brandonpollack23/super_game_bro/SW/images/lcd-image-converter/readme.txt

LCD Image Converter
Tool to create bitmaps and fonts for embedded applications, v.2
This program allows you to create bitmaps and fonts, and transform them to "C"
source format for embedded applications.

Home page: http://code.google.com/p/lcd-image-converter/
Mailto:    riuson@gmail.com

================================================================================
This program is free software: you can redistribute it and/or modify
it under the terms of the GNU General Public License as published by
the Free Software Foundation, either version 3 of the License, or
(at your option) any later version.

This program is distributed in the hope that it will be useful,
but WITHOUT ANY WARRANTY; without even the implied warranty of
MERCHANTABILITY or FITNESS FOR A PARTICULAR PURPOSE.  See the
GNU General Public License for more details.

You should have received a copy of the GNU General Public License
along with this program.  If not, see <http://www.gnu.org/licenses/

================================================================================
