brandonpollack23/super_game_bro/doc/CARTRIDGES/IDFReport_SD_MMC Breakout-v20.html

Altium customize

# IDF File Translation Report

Date | : | 2/13/15
Time | : | 3:56:46 PM
Elapsed Time | : | 00:00:00
PCB Filename | : | \\psf\Dropbox\school\SENIORDESIGN\Altium\SuperGameBro_RevA0\SuperGameBro_RevA0.PcbDoc
IDF Board Filename | : | \\psf\Dropbox\school\SENIORDESIGN\doc\cartridges\SD_MMC Breakout-v20.brd
IDF Library Filename | : | \\psf\Dropbox\school\SENIORDESIGN\doc\cartridges\SD_MMC Breakout-v20.pro

Load Errors

File : \\psf\Dropbox\school\SENIORDESIGN\doc\cartridges\SD_MMC Breakout-v20.brd Line : 3 Char : 2 Unknown IDF file section name <!DOCTYPE.

Back to top

Import Errors

Back to top

Load Warnings

Back to top

Import Warnings

Back to top

Errors

Back to top

Warnings

Back to top
