brandonpollack23/super_game_bro/doc/Butttons/Untitled.rtf

http://www.digikey.com/product-detail/en/15551/679-1964-ND/2034520 L+R button
http://www.digikey.com/product-detail/en/1630006/679-1971-ND/2034527 cap
