brandonpollack23/super_game_bro/Reports/Preliminary Design/Ganttchart.xls

Sheet: Gantt1
Task Name |  | Riley | Brandon | Team
Introduction (team) | 0 | 0 | 0 | 1 | 1
Research/project proposal (team) | 0 | 0 | 0 | 3 | 4
Prelimnary Hardware Design | 2 | 2 | 0 | 0 | 4
Prelimnary Software Design | 2 | 0 | 2 | 0 | 4
Circuit Testing | 4 | 2 | 0 | 0 | 6
Integrating Circuits with Software | 4 | 0 | 2 | 0 | 6
Altium Board Design uController | 5 | 0 | 2 | 0 | 6
Altium Board Design Periferal Circuits | 5 | 2 | 0 | 0 | 7
Devolping Demo Software | 7 | 0 | 0 | 3 | 10
Integrating Software with Final Board | 9 | 0 | 0 | 1 | 10
Integrating Software with Final Board | 10 | 0 | 1 | 0 | 11
PCB Revision (If nessisary) | 11 | 0 | 0 | 2 | 13
Create Case | 12 | 1 | 0 | 0 | 13
Demo (team) | 13 | 0 | 0 | 1 | 14

Sheet: Gantt2
Task Name |  | Op1 | Op2 | Diamond
Task1 | 0 | 5 | 3 | 1 | 9
Task2 | 9 | 5 | 0 | 0 | 14
Task3 | 14 | 0 | 0 | 0 | 14
Task4 | 14 | 0 | 3 | 1 | 18
Task5 | 18 | 6 | 0 | 0 | 24
Task6 | 24 | 5 | 0 | 0 | 29
Task7 | 29 | 0 | 0 | 1 | 30
Task8 | 30 | 0 | 0 | 0 | 30
Task9 | 30 | 0 | 2 | 0 | 32
Task10 | 32 | 7 | 0 | 0 | 39
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
