brandonpollack23/super_game_bro/Reports/Preliminary Design/images/Audio - New Page.png

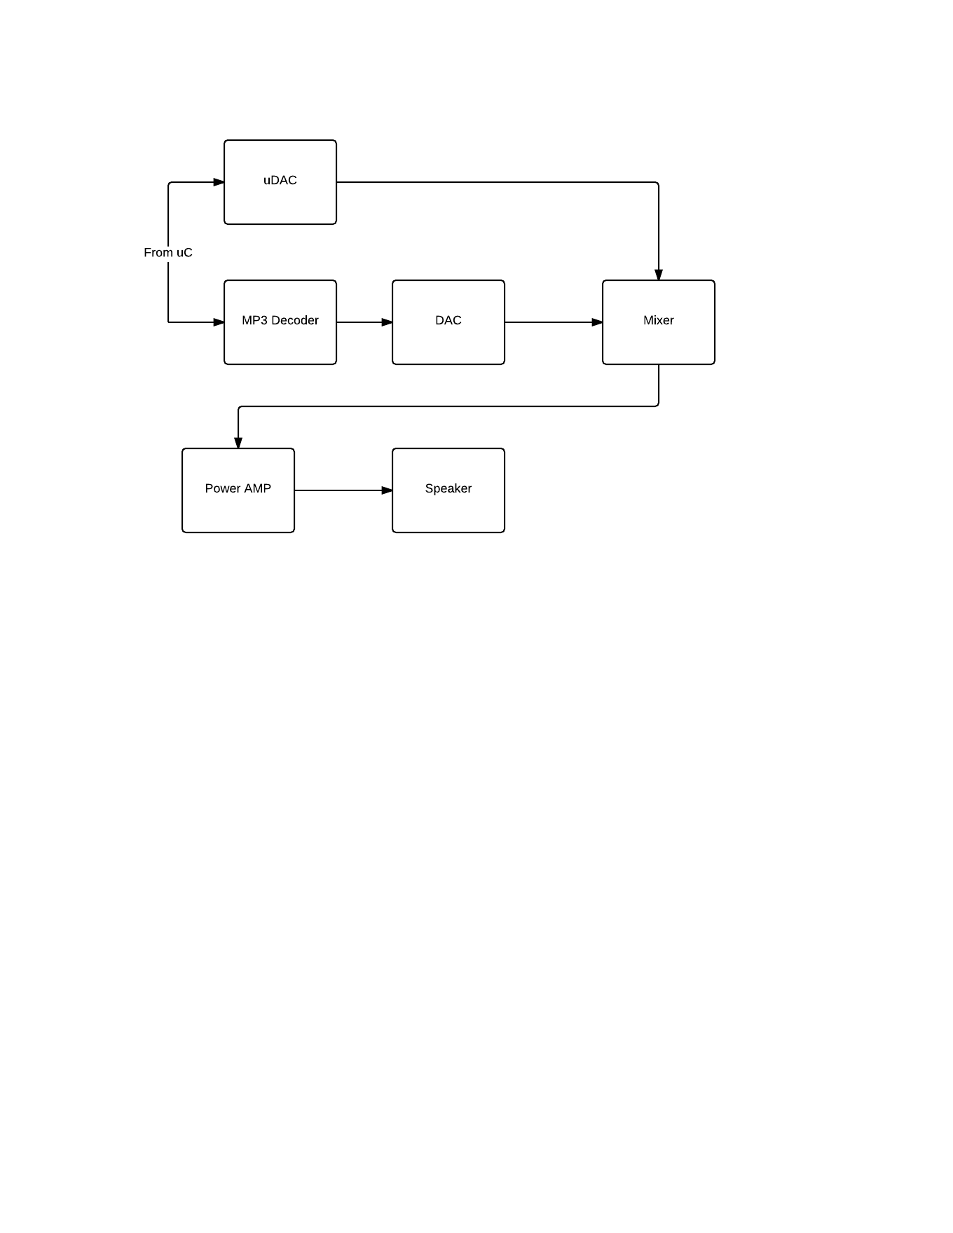
Reports/Preliminary Design/images/Audio - New Page.png
