brandonpollack23/super_game_bro/Reports/Preliminary Design/images/GameMan Software Flowchart - New Page.png

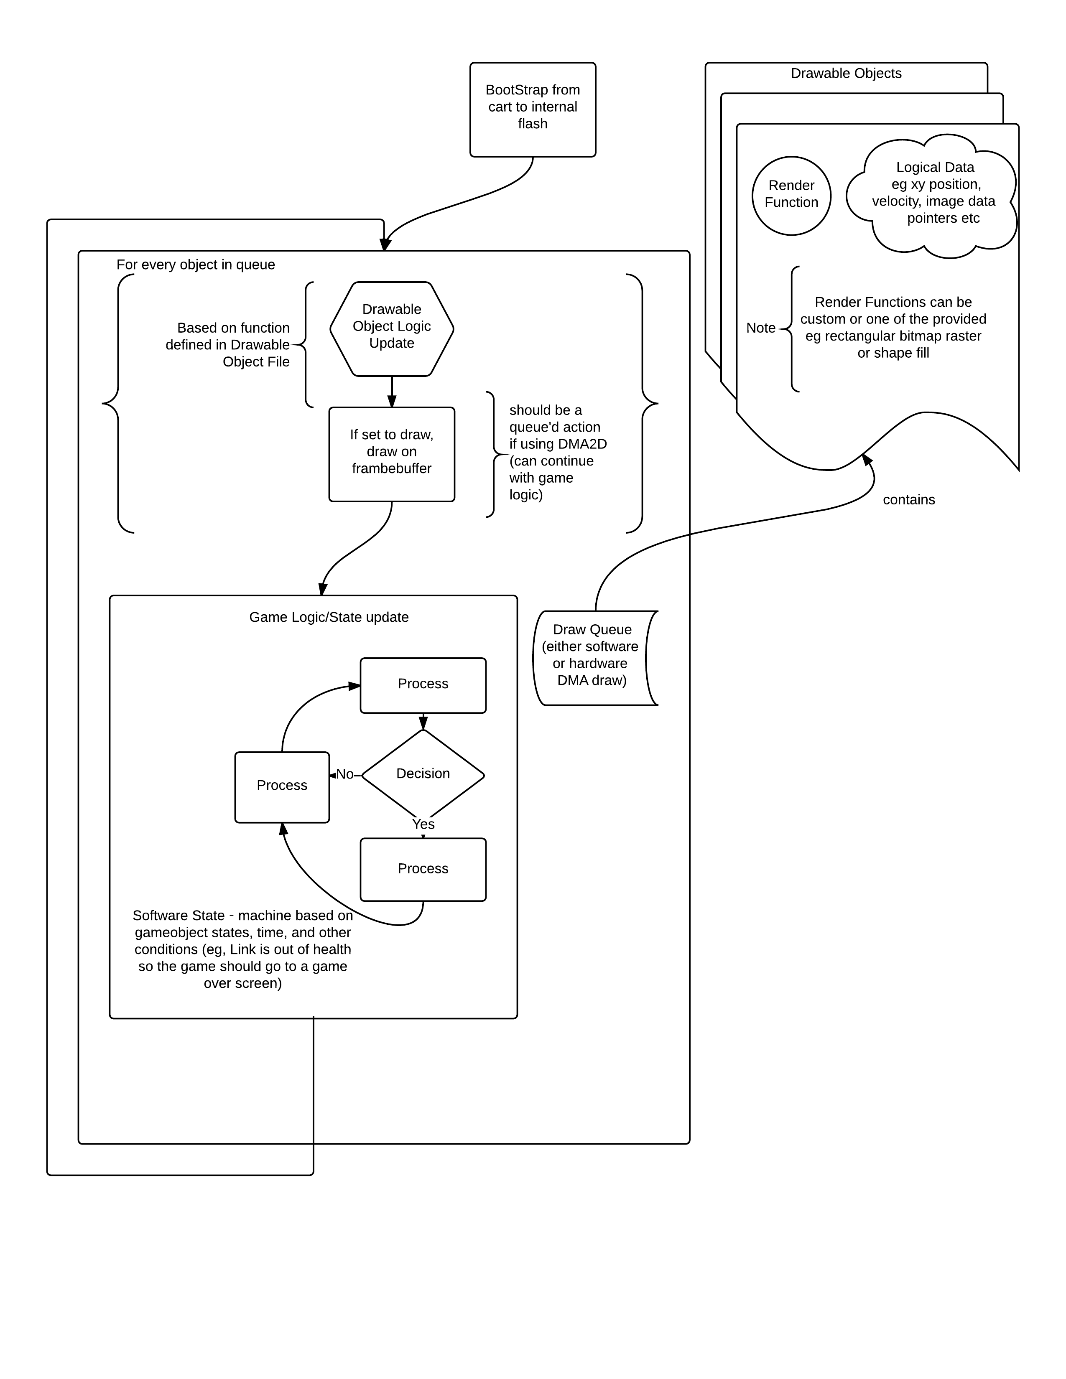
Reports/Preliminary Design/images/GameMan Software Flowchart - New Page.png
