brandonpollack23/super_game_bro/Reports/Preliminary Design/images/I-O - New Page.png

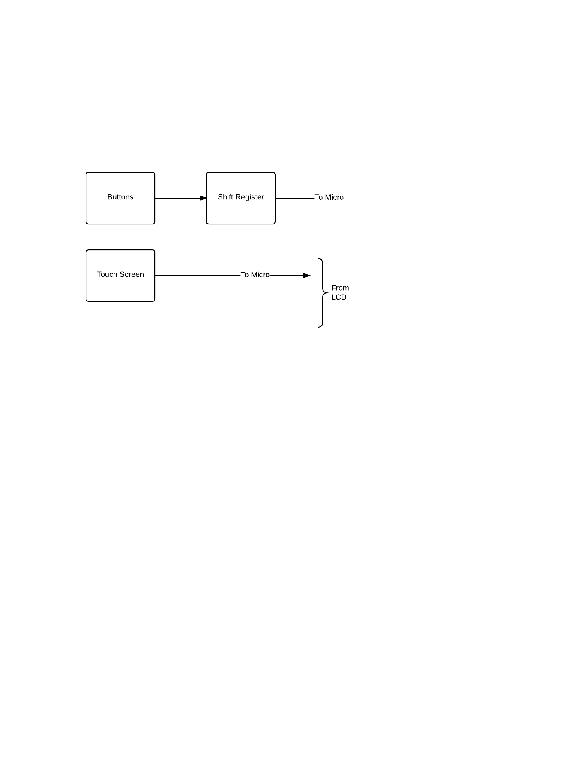
Reports/Preliminary Design/images/I-O - New Page.png
