brandonpollack23/super_game_bro/Reports/Preliminary Design/images/Memory-uController - New Page (1).png

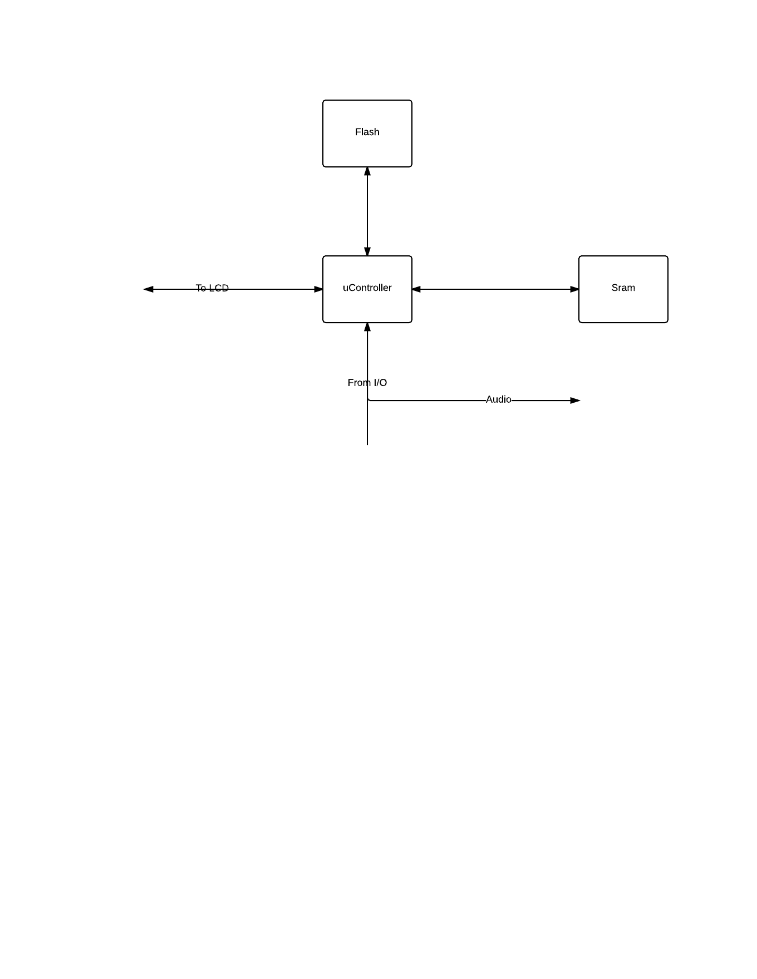
Reports/Preliminary Design/images/Memory-uController - New Page (1).png
