brandonpollack23/super_game_bro/Reports/Preliminary Design/images/Power Supply - New Page.png

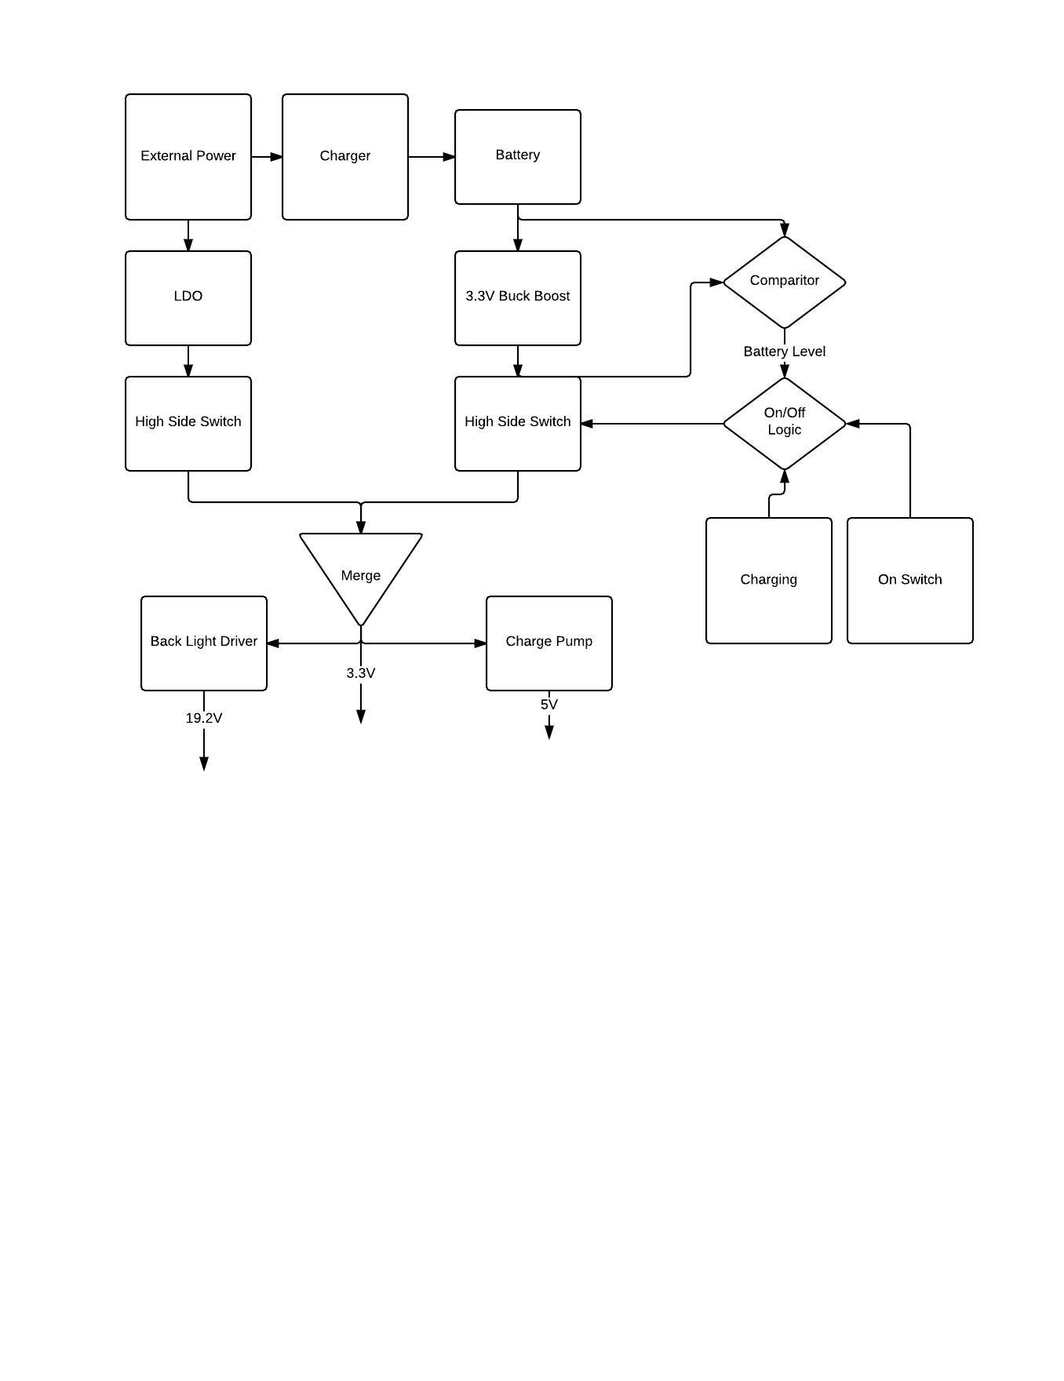
Reports/Preliminary Design/images/Power Supply - New Page.png
