brandonpollack23/super_game_bro/SW/GameMan_Template/GameMan_Template.jpg

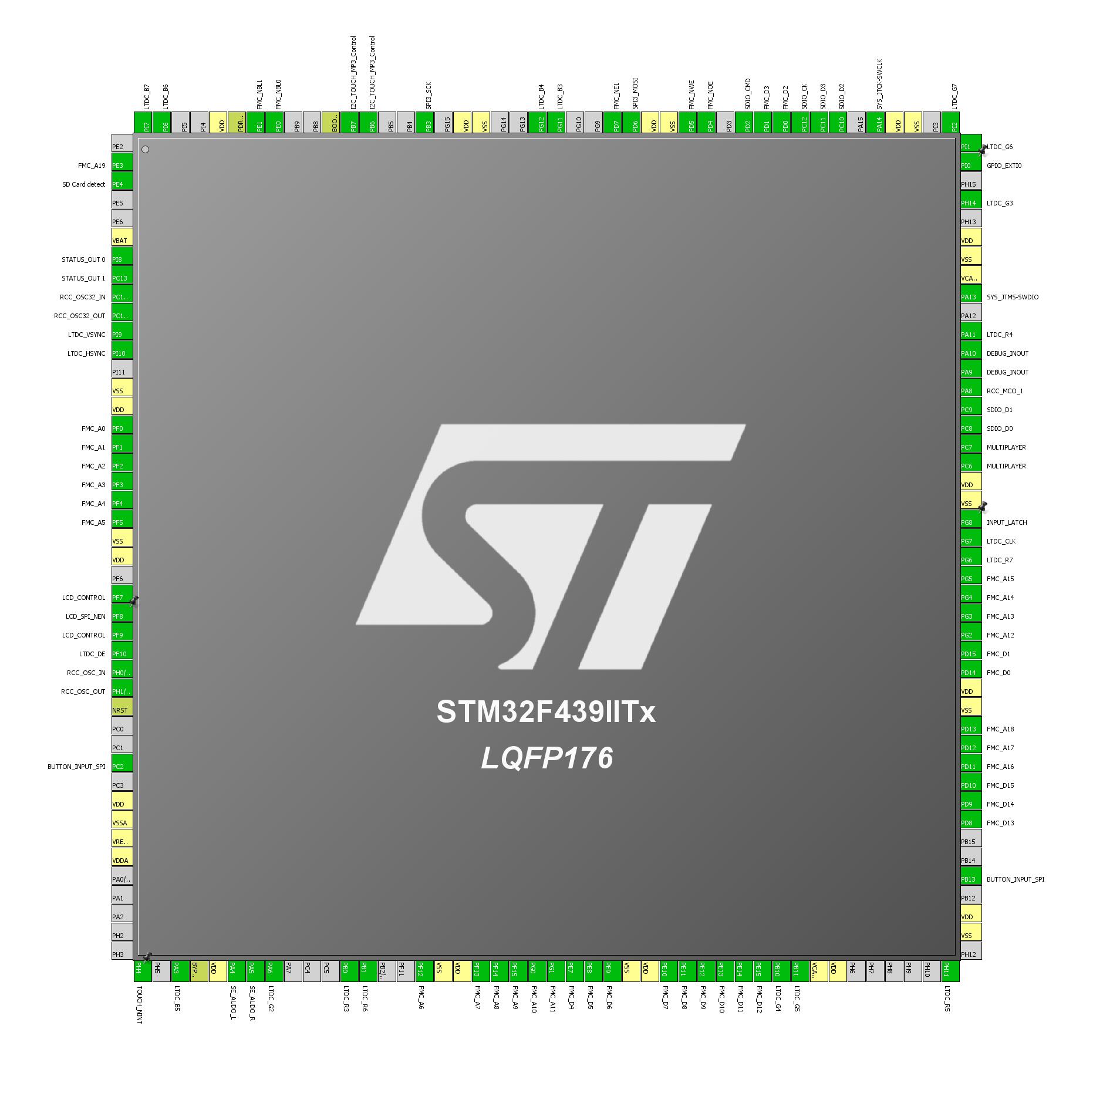
SW/GameMan_Template/GameMan_Template.jpg
