brandonpollack23/super_game_bro/doc/Connectors/parts.rtf

http://www.digikey.com/product-search/en?x=0&y=0&lang=en&site=us&keywords=0039281083 power
