brandonpollack23/super_game_bro/doc/AUDIO/parts.txt

http://www.digikey.com/product-detail/en/1N4148WS/1N4148WSFSCT-ND/1873821
http://www.digikey.com/product-detail/en/FMB2227A/FMB2227ACT-ND/3504401
