brandonpollack23/super_game_bro/(list of files, drawings)

Other design files:
Altium/Audio Breakout/Audio.PcbDoc
Altium/Audio Breakout/Audio.SchDoc
Altium/Audio Breakout/Audio_Breakout.PrjPcb
Altium/Baacklight/Backlight.PcbDoc
Altium/Baacklight/Backlight.PrjPcb
Altium/Baacklight/Backlight.SchDoc
Altium/LCD_breakout/lcd_breakout.PcbDoc
Altium/LCD_breakout/LCD_breakout.PrjPcb
Altium/LCD_breakout/lcd_breakout.SchDoc
Altium/Power/Power Test Board/Power Breakout.PcbDoc
Altium/Power/Power Test Board/Power_Breakout.PrjPcb
Altium/Power/Power Test Board/Power_Breakout.SchDoc
Altium/Power/Power/Control_Sig.SchDoc
Altium/Power/Power/Control_Sig_old.SchDoc
Altium/Power/Power/History/Control_Sig.~(9).SchDoc
Altium/Power/Power/History/Power.~(5).SchDoc
Altium/Power/Power/Power.PcbDoc
Altium/Power/Power/Power.PrjPcb
Altium/Power/Power/Power.SchDoc
Altium/Power/Power_TEst/Power.PcbDoc
Altium/Power/Power_TEst/Power.PrjPcb
Altium/Power/Power_TEst/Power.SchDoc
Altium/shift_reg_breakout/shift_reg_breakout.PcbDoc
Altium/shift_reg_breakout/shift_reg_breakout.PrjPcb
Altium/shift_reg_breakout/shift_reg_breakout.SchDoc
Altium/SuperGameBro_RevA0/Audio.SchDoc
Altium/SuperGameBro_RevA0/Buttons.SchDoc
Altium/SuperGameBro_RevA0/CPU_Power_XTAL_Prog.SchDoc
Altium/SuperGameBro_RevA0/History/SuperGameBro_RevA1.~(138).PcbDoc
Altium/SuperGameBro_RevA0/LCD_touch_conn.SchDoc
Altium/SuperGameBro_RevA0/sdcard_ram.SchDoc
Altium/SuperGameBro_RevA0/SuperGameBro_RevA0.PcbDoc
Altium/SuperGameBro_RevA0/SuperGameBro_RevA0.PrjPcb
Altium/SuperGameBro_RevA0/SuperGameBro_RevA1.PcbDoc
