brandonpollack23/super_game_bro/SW/GameMan_Template/Src/main.c

/**
  ******************************************************************************
  * File Name          : main.c
  * Date               : 02/03/2015 17:16:37
  * Description        : Main program body
  ******************************************************************************
  *
  * COPYRIGHT(c) 2015 STMicroelectronics
  *
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
  ******************************************************************************
  */

/* Includes ------------------------------------------------------------------*/
#include "stm32f4xx_hal.h"
#include "ff.h"
#include "ff_gen_drv.h"
#include "sd_diskio.h" /* defines SD_Driver as external */

/* USER CODE BEGIN Includes */
#include "GameMan_RevA0.h"
#include "TestGame.h"
#include "stdio.h"
#include "stdlib.h"

#include "DrawQueue.h"
//for printf rerouting to UART
#include <rt_misc.h>

/* USER CODE END Includes */

DAC_HandleTypeDef hdac;

DMA2D_HandleTypeDef hdma2d;

I2C_HandleTypeDef hi2c1;

LTDC_HandleTypeDef hltdc;

RNG_HandleTypeDef hrng;

SD_HandleTypeDef hsd;
HAL_SD_CardInfoTypedef SDCardInfo;

SPI_HandleTypeDef input_spi;
SPI_HandleTypeDef mp3_spi;
SPI_HandleTypeDef lcd_spi;

UART_HandleTypeDef huart1;
UART_HandleTypeDef huart6;

SRAM_HandleTypeDef hsram1;

uint8_t retSD;    /* Return value for SD */
char SD_Path[4];  /* SD logical drive path */
FIL file;
void SystemClock_Config(void);
static void MX_GPIO_Init(void);
static void MX_DAC_Init(void);
static void MX_DMA2D_Init(void);
static void MX_FMC_Init(void);
static void MX_I2C1_Init(void);
static void MX_LTDC_Init(void);
static void MX_RNG_Init(void);
static void MX_SDIO_SD_Init(void);
static void MX_SPI2_Init(void);
static void MX_SPI3_Init(void);
static void MX_SPI5_Init(void);
static void MX_USART1_UART_Init(void);
static void MX_USART6_UART_Init(void);

/* USER CODE BEGIN PFP */
void configureMP3(uint16_t addr);

/* USER CODE END PFP */

int main(void)
{

  /* USER CODE BEGIN 1 */
	//Declarations
	FATFS sdcard;
	
	LTDC_LayerCfgTypeDef layer1;
  /* USER CODE END 1 */

  /* MCU Configuration----------------------------------------------------------*/

  /* Reset of all peripherals, Initializes the Flash interface and the Systick. */
  HAL_Init();

  /* Configure the system clock */
  SystemClock_Config();

  /* Initialize all configured peripherals */
  MX_GPIO_Init();
  MX_DAC_Init();
  MX_DMA2D_Init();
  MX_FMC_Init();
  MX_I2C1_Init();
  MX_LTDC_Init();
  MX_RNG_Init();
  MX_SDIO_SD_Init();
  MX_SPI2_Init();
  MX_SPI3_Init();
  MX_SPI5_Init();
  MX_USART1_UART_Init();
  MX_USART6_UART_Init();

  /* USER CODE BEGIN 2 */
	framebuffer_layer_init(&layer1,SPRITE_LAYER_NUM,framebuffer_1);
	NV3035_init();
  /* USER CODE END 2 */

  /*## FatFS: Link the SD driver ###########################*/
  if(FATFS_LinkDriver(&SD_Driver, SD_Path) != 0) //prepare SD card
	{
		if(f_mount(&sdcard,(TCHAR const*)SD_Path,0) != FR_OK)
		{
			Error_Handler();
		}
		else
		{
			//TODO change to 4 bit mode
			runGame();
		}
	}
	
}

/** System Clock Configuration
*/
void SystemClock_Config(void)
{

  RCC_OscInitTypeDef RCC_OscInitStruct;
  RCC_ClkInitTypeDef RCC_ClkInitStruct;
  RCC_PeriphCLKInitTypeDef PeriphClkInitStruct;

  __PWR_CLK_ENABLE();

  __HAL_PWR_VOLTAGESCALING_CONFIG(PWR_REGULATOR_VOLTAGE_SCALE1);

  RCC_OscInitStruct.OscillatorType = RCC_OSCILLATORTYPE_HSI|RCC_OSCILLATORTYPE_HSE;
  RCC_OscInitStruct.HSEState = RCC_HSE_ON;
  RCC_OscInitStruct.HSIState = RCC_HSI_ON;
  RCC_OscInitStruct.HSICalibrationValue = 6;
  RCC_OscInitStruct.PLL.PLLState = RCC_PLL_ON;
  RCC_OscInitStruct.PLL.PLLSource = RCC_PLLSOURCE_HSE;
  RCC_OscInitStruct.PLL.PLLM = 10;
  RCC_OscInitStruct.PLL.PLLN = 360;
  RCC_OscInitStruct.PLL.PLLP = RCC_PLLP_DIV2;
  RCC_OscInitStruct.PLL.PLLQ = 8;
  HAL_RCC_OscConfig(&RCC_OscInitStruct);

  HAL_PWREx_ActivateOverDrive();

  RCC_ClkInitStruct.ClockType = RCC_CLOCKTYPE_SYSCLK|RCC_CLOCKTYPE_PCLK1
                              |RCC_CLOCKTYPE_PCLK2;
  RCC_ClkInitStruct.SYSCLKSource = RCC_SYSCLKSOURCE_PLLCLK;
  RCC_ClkInitStruct.AHBCLKDivider = RCC_SYSCLK_DIV1;
  RCC_ClkInitStruct.APB1CLKDivider = RCC_HCLK_DIV4;
  RCC_ClkInitStruct.APB2CLKDivider = RCC_HCLK_DIV4;
  HAL_RCC_ClockConfig(&RCC_ClkInitStruct, FLASH_LATENCY_5);

  PeriphClkInitStruct.PeriphClockSelection = RCC_PERIPHCLK_LTDC;
  PeriphClkInitStruct.PLLSAI.PLLSAIN = 256;
  PeriphClkInitStruct.PLLSAI.PLLSAIR = 5;
  PeriphClkInitStruct.PLLSAIDivR = RCC_PLLSAIDIVR_8;
  HAL_RCCEx_PeriphCLKConfig(&PeriphClkInitStruct);

  HAL_RCC_MCOConfig(RCC_MCO1, RCC_MCO1SOURCE_HSI, RCC_MCODIV_1);

}

/* DAC init function */
void MX_DAC_Init(void)
{

  DAC_ChannelConfTypeDef sConfig;

    /**DAC Initialization 
    */
  hdac.Instance = DAC;
  HAL_DAC_Init(&hdac);

    /**DAC channel OUT1 config 
    */
  sConfig.DAC_Trigger = DAC_TRIGGER_NONE;
  sConfig.DAC_OutputBuffer = DAC_OUTPUTBUFFER_ENABLE;
  HAL_DAC_ConfigChannel(&hdac, &sConfig, DAC_CHANNEL_1);

    /**DAC channel OUT2 config 
    */
  HAL_DAC_ConfigChannel(&hdac, &sConfig, DAC_CHANNEL_2);

}

/* DMA2D init function */
void MX_DMA2D_Init(void)
{

  hdma2d.Instance = DMA2D;
  hdma2d.Init.Mode = DMA2D_M2M;
  hdma2d.Init.ColorMode = DMA2D_ARGB8888;
  hdma2d.Init.OutputOffset = 0;
  HAL_DMA2D_Init(&hdma2d);

}

/* I2C1 init function */
void MX_I2C1_Init(void)
{

  hi2c1.Instance = I2C1;
  hi2c1.Init.ClockSpeed = 100000;
  hi2c1.Init.DutyCycle = I2C_DUTYCYCLE_2;
  hi2c1.Init.OwnAddress1 = 0;
  hi2c1.Init.AddressingMode = I2C_ADDRESSINGMODE_7BIT;
  hi2c1.Init.DualAddressMode = I2C_DUALADDRESS_DISABLED;
  hi2c1.Init.OwnAddress2 = 0;
  hi2c1.Init.GeneralCallMode = I2C_GENERALCALL_DISABLED;
  hi2c1.Init.NoStretchMode = I2C_NOSTRETCH_DISABLED;
  HAL_I2C_Init(&hi2c1);

}

/* LTDC init function */
void MX_LTDC_Init(void)
{
  hltdc.Instance = LTDC;
  hltdc.Init.HSPolarity = LTDC_HSPOLARITY_AL;
  hltdc.Init.VSPolarity = LTDC_VSPOLARITY_AL;
  hltdc.Init.DEPolarity = LTDC_DEPOLARITY_AL;
  hltdc.Init.PCPolarity = LTDC_PCPOLARITY_IPC;
  hltdc.Init.HorizontalSync = 0;
  hltdc.Init.VerticalSync = 0;
  hltdc.Init.AccumulatedHBP = 70;
  hltdc.Init.AccumulatedVBP = 13;
  hltdc.Init.AccumulatedActiveW = 390;
  hltdc.Init.AccumulatedActiveH = 253;
  hltdc.Init.TotalWidth = 408;
  hltdc.Init.TotalHeigh = 263;
  hltdc.Init.Backcolor.Blue = 0;
  hltdc.Init.Backcolor.Green = 0;
  hltdc.Init.Backcolor.Red = 0;
  HAL_LTDC_Init(&hltdc);

}

/* RNG init function */
void MX_RNG_Init(void)
{

  hrng.Instance = RNG;
  HAL_RNG_Init(&hrng);

}

/* SDIO init function */
void MX_SDIO_SD_Init(void)
{

  hsd.Instance = SDIO;
  hsd.Init.ClockEdge = SDIO_CLOCK_EDGE_RISING;
  hsd.Init.ClockBypass = SDIO_CLOCK_BYPASS_DISABLE;
  hsd.Init.ClockPowerSave = SDIO_CLOCK_POWER_SAVE_DISABLE;
  hsd.Init.BusWide = SDIO_BUS_WIDE_1B;
  hsd.Init.HardwareFlowControl = SDIO_HARDWARE_FLOW_CONTROL_DISABLE;
  hsd.Init.ClockDiv = 0;

}

/* SPI2 init function */
void MX_SPI2_Init(void)
{

  input_spi.Instance = SPI2;
  input_spi.Init.Mode = SPI_MODE_MASTER;
  input_spi.Init.Direction = SPI_DIRECTION_2LINES;
  input_spi.Init.DataSize = SPI_DATASIZE_16BIT;
  input_spi.Init.CLKPolarity = SPI_POLARITY_LOW;
  input_spi.Init.CLKPhase = SPI_PHASE_1EDGE;
  input_spi.Init.NSS = SPI_NSS_SOFT;
  input_spi.Init.BaudRatePrescaler = SPI_BAUDRATEPRESCALER_2;
  input_spi.Init.FirstBit = SPI_FIRSTBIT_MSB;
  input_spi.Init.TIMode = SPI_TIMODE_DISABLED;
  input_spi.Init.CRCCalculation = SPI_CRCCALCULATION_DISABLED;
  HAL_SPI_Init(&input_spi);

}

/* SPI3 init function */
void MX_SPI3_Init(void)
{

  mp3_spi.Instance = SPI3;
  mp3_spi.Init.Mode = SPI_MODE_MASTER;
  mp3_spi.Init.Direction = SPI_DIRECTION_2LINES;
  mp3_spi.Init.DataSize = SPI_DATASIZE_8BIT;
  mp3_spi.Init.CLKPolarity = SPI_POLARITY_HIGH;
  mp3_spi.Init.CLKPhase = SPI_PHASE_1EDGE;
  mp3_spi.Init.NSS = SPI_NSS_SOFT;
  mp3_spi.Init.BaudRatePrescaler = SPI_BAUDRATEPRESCALER_4;
  mp3_spi.Init.FirstBit = SPI_FIRSTBIT_MSB;
  mp3_spi.Init.TIMode = SPI_TIMODE_DISABLED;
  mp3_spi.Init.CRCCalculation = SPI_CRCCALCULATION_DISABLED;
  HAL_SPI_Init(&mp3_spi);

}

/* SPI5 init function */
void MX_SPI5_Init(void)
{

  lcd_spi.Instance = SPI5;
  lcd_spi.Init.Mode = SPI_MODE_MASTER;
  lcd_spi.Init.Direction = SPI_DIRECTION_2LINES;
  lcd_spi.Init.DataSize = SPI_DATASIZE_8BIT;
  lcd_spi.Init.CLKPolarity = SPI_POLARITY_LOW;
  lcd_spi.Init.CLKPhase = SPI_PHASE_1EDGE;
  lcd_spi.Init.NSS = SPI_NSS_SOFT;
  lcd_spi.Init.BaudRatePrescaler = SPI_BAUDRATEPRESCALER_16;
  lcd_spi.Init.FirstBit = SPI_FIRSTBIT_MSB;
  lcd_spi.Init.TIMode = SPI_TIMODE_DISABLED;
  lcd_spi.Init.CRCCalculation = SPI_CRCCALCULATION_DISABLED;
  HAL_SPI_Init(&lcd_spi);

}

/* USART1 init function */
void MX_USART1_UART_Init(void)
{

  huart1.Instance = USART1;
  huart1.Init.BaudRate = 9600;
  huart1.Init.WordLength = UART_WORDLENGTH_8B;
  huart1.Init.StopBits = UART_STOPBITS_1;
  huart1.Init.Parity = UART_PARITY_NONE;
  huart1.Init.Mode = UART_MODE_TX_RX;
  huart1.Init.HwFlowCtl = UART_HWCONTROL_NONE;
  huart1.Init.OverSampling = UART_OVERSAMPLING_16;
  HAL_UART_Init(&huart1);

}

/* USART6 init function */
void MX_USART6_UART_Init(void)
{

  huart6.Instance = USART6;
  huart6.Init.BaudRate = 115200;
  huart6.Init.WordLength = UART_WORDLENGTH_8B;
  huart6.Init.StopBits = UART_STOPBITS_1;
  huart6.Init.Parity = UART_PARITY_NONE;
  huart6.Init.Mode = UART_MODE_TX_RX;
  huart6.Init.HwFlowCtl = UART_HWCONTROL_NONE;
  huart6.Init.OverSampling = UART_OVERSAMPLING_16;
  HAL_UART_Init(&huart6);

}
/* FMC initialization function */
void MX_FMC_Init(void)
{
  FMC_NORSRAM_TimingTypeDef Timing;

  /** Perform the SRAM1 memory initialization sequence
  */
  hsram1.Instance = FMC_NORSRAM_DEVICE;
  hsram1.Extended = FMC_NORSRAM_EXTENDED_DEVICE;
  /* hsram1.Init */
  hsram1.Init.NSBank = FMC_NORSRAM_BANK1;
  hsram1.Init.DataAddressMux = FMC_DATA_ADDRESS_MUX_DISABLE;
  hsram1.Init.MemoryType = FMC_MEMORY_TYPE_SRAM;
  hsram1.Init.MemoryDataWidth = FMC_NORSRAM_MEM_BUS_WIDTH_16;
  hsram1.Init.BurstAccessMode = FMC_BURST_ACCESS_MODE_DISABLE;
  hsram1.Init.WaitSignalPolarity = FMC_WAIT_SIGNAL_POLARITY_LOW;
  hsram1.Init.WrapMode = FMC_WRAP_MODE_DISABLE;
  hsram1.Init.WaitSignalActive = FMC_WAIT_TIMING_BEFORE_WS;
  hsram1.Init.WriteOperation = FMC_WRITE_OPERATION_ENABLE;
  hsram1.Init.WaitSignal = FMC_WAIT_SIGNAL_DISABLE;
  hsram1.Init.ExtendedMode = FMC_EXTENDED_MODE_DISABLE;
  hsram1.Init.AsynchronousWait = FMC_ASYNCHRONOUS_WAIT_DISABLE;
  hsram1.Init.WriteBurst = FMC_WRITE_BURST_DISABLE;
  hsram1.Init.ContinuousClock = FMC_CONTINUOUS_CLOCK_SYNC_ONLY;
  /* Timing */
  Timing.AddressSetupTime = 0;
  Timing.AddressHoldTime = 15;
  Timing.DataSetupTime = 6;
  Timing.BusTurnAroundDuration = 0;
  Timing.CLKDivision = 16;
  Timing.DataLatency = 17;
  Timing.AccessMode = FMC_ACCESS_MODE_A;
  /* ExtTiming */

  HAL_SRAM_Init(&hsram1, &Timing, NULL);

}

/** Configure pins as 
        * Analog 
        * Input 
        * Output
        * EVENT_OUT
        * EXTI
     PA8   ------> RCC_MCO_1
*/
void MX_GPIO_Init(void)
{

  GPIO_InitTypeDef GPIO_InitStruct;

  /* GPIO Ports Clock Enable */
  __GPIOE_CLK_ENABLE();
  __GPIOI_CLK_ENABLE();
  __GPIOC_CLK_ENABLE();
  __GPIOF_CLK_ENABLE();
  __GPIOH_CLK_ENABLE();
  __GPIOA_CLK_ENABLE();
  __GPIOB_CLK_ENABLE();
  __GPIOG_CLK_ENABLE();
  __GPIOD_CLK_ENABLE();

  /*Configure GPIO pin : PE4 */
  GPIO_InitStruct.Pin = GPIO_PIN_4;
  GPIO_InitStruct.Mode = GPIO_MODE_INPUT;
  GPIO_InitStruct.Pull = GPIO_NOPULL;
  HAL_GPIO_Init(GPIOE, &GPIO_InitStruct);

  /*Configure GPIO pin : PI8 */
  GPIO_InitStruct.Pin = GPIO_PIN_8;
  GPIO_InitStruct.Mode = GPIO_MODE_OUTPUT_PP;
  GPIO_InitStruct.Pull = GPIO_NOPULL;
  GPIO_InitStruct.Speed = GPIO_SPEED_LOW;
  HAL_GPIO_Init(GPIOI, &GPIO_InitStruct);

  /*Configure GPIO pin : PC13 */
  GPIO_InitStruct.Pin = GPIO_PIN_13;
  GPIO_InitStruct.Mode = GPIO_MODE_OUTPUT_PP;
  GPIO_InitStruct.Pull = GPIO_NOPULL;
  GPIO_InitStruct.Speed = GPIO_SPEED_LOW;
  HAL_GPIO_Init(GPIOC, &GPIO_InitStruct);

  /*Configure GPIO pin : PF8 */
  GPIO_InitStruct.Pin = GPIO_PIN_8;
  GPIO_InitStruct.Mode = GPIO_MODE_OUTPUT_PP;
  GPIO_InitStruct.Pull = GPIO_NOPULL;
  GPIO_InitStruct.Speed = GPIO_SPEED_LOW;
  HAL_GPIO_Init(GPIOF, &GPIO_InitStruct);
	
	HAL_GPIO_WritePin(GPIOF,GPIO_PIN_8,GPIO_PIN_SET);

  /*Configure GPIO pin : PH4 */
  GPIO_InitStruct.Pin = GPIO_PIN_4;
  GPIO_InitStruct.Mode = GPIO_MODE_INPUT;
  GPIO_InitStruct.Pull = GPIO_NOPULL;
  HAL_GPIO_Init(GPIOH, &GPIO_InitStruct);

  /*Configure GPIO pin : PG8 */
  GPIO_InitStruct.Pin = GPIO_PIN_8;
  GPIO_InitStruct.Mode = GPIO_MODE_OUTPUT_PP;
  GPIO_InitStruct.Pull = GPIO_NOPULL;
  GPIO_InitStruct.Speed = GPIO_SPEED_HIGH;
  HAL_GPIO_Init(GPIOG, &GPIO_InitStruct);

  /*Configure GPIO pin : PA8 */
  GPIO_InitStruct.Pin = GPIO_PIN_8;
  GPIO_InitStruct.Mode = GPIO_MODE_AF_PP;
  GPIO_InitStruct.Pull = GPIO_NOPULL;
  GPIO_InitStruct.Speed = GPIO_SPEED_LOW;
  GPIO_InitStruct.Alternate = GPIO_AF0_MCO;
  HAL_GPIO_Init(GPIOA, &GPIO_InitStruct);

  /*Configure GPIO pin : PI0 */
  GPIO_InitStruct.Pin = GPIO_PIN_0;
  GPIO_InitStruct.Mode = GPIO_MODE_EVT_RISING;
  GPIO_InitStruct.Pull = GPIO_NOPULL;
  HAL_GPIO_Init(GPIOI, &GPIO_InitStruct);

}

/* USER CODE BEGIN 4 */
//crap not printf debug
HAL_StatusTypeDef print_debug(uint8_t *pData, uint16_t Size, uint32_t Timeout)
{
	return HAL_UART_Transmit(DEBUG_UART,pData,Size, Timeout);
}

//printf configuration from forums 
#pragma import(__use_no_semihosting_swi)
 
struct __FILE { int handle; /* Add whatever you need here */ };
FILE __stdout;
FILE __stdin;
 
int fputc(int ch, FILE *f)
{
    //while(__HAL_UART_GET_FLAG(DEBUG_UART, UART_FLAG_TXE) == RESET);
 
  HAL_UART_Transmit(DEBUG_UART, (uint8_t*) &ch, 1, 1000);
 
  return(ch);
}
 
int fgetc(FILE *f)
{
    char ch;
 
    //while(__HAL_UART_GET_FLAG(DEBUG_UART, UART_FLAG_RXNE) == RESET);
 
    ch = HAL_UART_Receive(DEBUG_UART,(uint8_t*) &ch, 1 , 10);
 
  return((int)ch);
}
 
int ferror(FILE *f)
{
  /* Your implementation of ferror */
  return EOF;
}
 
void _ttywrch(int ch)
{
    //while(HAL_UART_GetFlagStatus(DEBUG_UART, UART_FLAG_TXE) == RESET);
 
  HAL_UART_Transmit(DEBUG_UART,(uint8_t*) ch, 1, 10);
}
 
void _sys_exit(int return_code)
{
label:  goto label;  /* endless loop */
}
/* USER CODE END 4 */

#ifdef USE_FULL_ASSERT

/**
   * @brief Reports the name of the source file and the source line number
   * where the assert_param error has occurred.
   * @param file: pointer to the source file name
   * @param line: assert_param error line source number
   * @retval None
   */
void assert_failed(uint8_t* file, uint32_t line)
{
  /* USER CODE BEGIN 6 */
  /* User can add his own implementation to report the file name and line number,
    ex: printf("Wrong parameters value: file %s on line %d\r\n", file, line) */
  /* USER CODE END 6 */

}

#endif

/**
  * @}
  */ 

/**
  * @}
*/ 

/************************ (C) COPYRIGHT STMicroelectronics *****END OF FILE****/
