brandonpollack23/super_game_bro/SW/GameMan_Template/GameMan_Template.ioc

Mcu.UserName=STM32F439IITx
PA10.GPIO_Label=DEBUG_INOUT
PA10.Signal=USART1_RX
PA11.Signal=LTDC_R4
PA13.Signal=SYS_JTMS-SWDIO
PA14.Signal=SYS_JTCK-SWCLK
PA3.Signal=LTDC_B5
PA4.GPIO_Label=SE_AUDO_L
PA4.Signal=COMP_DAC1_group
PA5.GPIO_Label=SE_AUDO_R
PA5.Signal=COMP_DAC2_group
PA6.Signal=LTDC_G2
PA8.Signal=RCC_MCO_1
PA9.GPIO_Label=DEBUG_INOUT
PA9.Signal=USART1_TX
PB0.Signal=LTDC_R3
PB1.Signal=LTDC_R6
PB10.Signal=LTDC_G4
PB11.Signal=LTDC_G5
PB13.GPIO_Label=BUTTON_INPUT_SPI
PB13.Signal=SPI2_SCK
PB3.Signal=SPI3_SCK
PB6.GPIO_Label=I2C_TOUCH_MP3_Control
PB6.Signal=I2C1_SCL
PB7.GPIO_Label=I2C_TOUCH_MP3_Control
PB7.Signal=I2C1_SDA
PC10.Signal=SDIO_D2
PC11.Signal=SDIO_D3
PC12.Signal=SDIO_CK
PC13.GPIO_Label=STATUS_OUT 1
PC13.Signal=GPIO_Output
PC14/OSC32_IN.Signal=RCC_OSC32_IN
PC15/OSC32_OUT.Signal=RCC_OSC32_OUT
PC2.GPIO_Label=BUTTON_INPUT_SPI
PC2.Signal=SPI2_MISO
PC6.GPIO_Label=MULTIPLAYER
PC6.Signal=USART6_TX
PC7.GPIO_Label=MULTIPLAYER
PC7.Signal=USART6_RX
PC8.Signal=SDIO_D0
PC9.Signal=SDIO_D1
PD0.Signal=FMC_D2_DA2
PD1.Signal=FMC_D3_DA3
PD10.Signal=FMC_D15_DA15
PD11.Signal=FMC_A16_CLE
PD12.Signal=FMC_A17_ALE
PD13.Signal=FMC_A18
PD14.Signal=FMC_D0_DA0
PD15.Signal=FMC_D1_DA1
PD2.Signal=SDIO_CMD
PD4.Signal=FMC_NOE
PD5.Signal=FMC_NWE
PD6.Signal=SPI3_MOSI
PD7.Signal=FMC_NE1
PD8.Signal=FMC_D13_DA13
PD9.Signal=FMC_D14_DA14
PE0.Signal=FMC_NBL0
PE1.Signal=FMC_NBL1
PE10.Signal=FMC_D7_DA7
PE11.Signal=FMC_D8_DA8
PE12.Signal=FMC_D9_DA9
PE13.Signal=FMC_D10_DA10
PE14.Signal=FMC_D11_DA11
PE15.Signal=FMC_D12_DA12
PE3.Signal=FMC_A19
PE4.GPIO_Label=SD Card detect
PE4.Signal=GPIO_Input
PE7.Signal=FMC_D4_DA4
PE8.Signal=FMC_D5_DA5
PE9.Signal=FMC_D6_DA6
PF0.Signal=FMC_A0
PF1.Signal=FMC_A1
PF10.Signal=LTDC_DE
PF12.Signal=FMC_A6
PF13.Signal=FMC_A7
PF14.Signal=FMC_A8
PF15.Signal=FMC_A9
PF2.Signal=FMC_A2
PF3.Signal=FMC_A3
PF4.Signal=FMC_A4
PF5.Signal=FMC_A5
PF7.GPIO_Label=LCD_CONTROL
PF7.Signal=SPI5_SCK
PF8.GPIO_Label=LCD_SPI_NEN
PF8.Signal=GPIO_Output
PF9.GPIO_Label=LCD_CONTROL
PF9.Signal=SPI5_MOSI
PG0.Signal=FMC_A10
PG1.Signal=FMC_A11
PG11.Signal=LTDC_B3
PG12.Signal=LTDC_B4
PG2.Signal=FMC_A12
PG3.Signal=FMC_A13
PG4.Signal=FMC_A14_BA0
PG5.Signal=FMC_A15_BA1
PG6.Signal=LTDC_R7
PG7.Signal=LTDC_CLK
PG8.GPIO_Label=INPUT_LATCH
PG8.Signal=GPIO_Output
PH0/OSC_IN.Signal=RCC_OSC_IN
PH1/OSC_OUT.Signal=RCC_OSC_OUT
PH11.Signal=LTDC_R5
PH14.Signal=LTDC_G3
PH4.Signal=GPXTI4
PI0.GPIO_Label=MP3_DR
PI0.Signal=GPXTI0
PI1.Signal=LTDC_G6
PI10.Signal=LTDC_HSYNC
PI2.Signal=LTDC_G7
PI6.Signal=LTDC_B6
PI7.Signal=LTDC_B7
PI8.GPIO_Label=STATUS_OUT 0
PI8.Signal=GPIO_Output
PI9.Signal=LTDC_VSYNC
