brandonpollack23/super_game_bro/SW/GameMan_Template/Src/bsp_driver_sd.c

/**
 ******************************************************************************
  * @file    bsp_driver_sd.c (based on stm324x9i_eval_sd.c)
  * @author  MCD Teams
  * @version V1.0.0
  * @date    04/03/2015 14:16:21
  * @brief   This file includes a generic uSD card driver.
  ******************************************************************************
  *
  * COPYRIGHT(c) 2015 STMicroelectronics
  *
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
  ******************************************************************************
  */

/* USER CODE BEGIN 0 */
/* Includes ------------------------------------------------------------------*/
#include "bsp_driver_sd.h"

/* Extern variables ---------------------------------------------------------*/ 
  
extern SD_HandleTypeDef hsd;
extern HAL_SD_CardInfoTypedef SDCardInfo; 

/**
  * @brief  Initializes the SD card device.
  * @param  None
  * @retval SD status
  */
uint8_t BSP_SD_Init(void)
{ 
  uint8_t SD_state = MSD_OK;
  
  /* Check if the SD card is plugged in the slot */
  if (BSP_SD_IsDetected() != SD_PRESENT)
  {
    return MSD_ERROR;
  }
  
  SD_state = HAL_SD_Init(&hsd, &SDCardInfo);
  if (SD_state == MSD_OK)
  {
    HAL_SD_CardStatusTypedef CardStatus;
    HAL_SD_GetCardStatus(&hsd, &CardStatus);
      
    if (CardStatus.DAT_BUS_WIDTH == 4) 
    {
      if (HAL_SD_WideBusOperation_Config(&hsd, SDIO_BUS_WIDE_4B) != SD_OK)
      {
        SD_state = MSD_ERROR;
      } 
      else
      {
        SD_state = MSD_OK;
      }
    }
    else
    {  
      if (HAL_SD_WideBusOperation_Config(&hsd, SDIO_BUS_WIDE_1B) != SD_OK)
      {
        SD_state = MSD_ERROR;
      } 
      else
      {
        SD_state = MSD_OK;
      }
    }
  } 
  return  SD_state;  
}

/**
  * @brief  Configures Interrupt mode for SD detection pin.
  * @param  None
  * @retval Returns 0 in success otherwise 1. 
  */
uint8_t BSP_SD_ITConfig(void)
{  
  /* TBI: add user code here depending on the hardware configuration used */
  
  return 0;
}

/** @brief  SD detect IT treatment
  * @param  None
  * @retval None
  */
void BSP_SD_DetectIT(void)
{
  /* TBI: add user code here depending on the hardware configuration used */
}

/** @brief  SD detect IT detection callback
  * @param  None
  * @retval None
  */
__weak void BSP_SD_DetectCallback(void)
{
  /* NOTE: This function Should not be modified, when the callback is needed,
  the SD_DetectCallback could be implemented in the user file
  */ 
  
}

/**
  * @brief  Reads block(s) from a specified address in an SD card, in polling mode. 
  * @param  pData: Pointer to the buffer that will contain the data to transmit
  * @param  ReadAddr: Address from where data is to be read  
  * @param  BlockSize: SD card data block size, that should be 512
  * @param  NumOfBlocks: Number of SD blocks to read 
  * @retval SD status
  */
uint8_t BSP_SD_ReadBlocks(uint32_t *pData, uint64_t ReadAddr, uint32_t BlockSize, uint32_t NumOfBlocks)
{
  if(HAL_SD_ReadBlocks(&hsd, pData, ReadAddr, BlockSize, NumOfBlocks) != SD_OK)  
  {
    return MSD_ERROR;
  }
  else
  {
    return MSD_OK;
  }
}

/**
  * @brief  Writes block(s) to a specified address in an SD card, in polling mode. 
  * @param  pData: Pointer to the buffer that will contain the data to transmit
  * @param  WriteAddr: Address from where data is to be written  
  * @param  BlockSize: SD card data block size, that should be 512
  * @param  NumOfBlocks: Number of SD blocks to write
  * @retval SD status
  */
uint8_t BSP_SD_WriteBlocks(uint32_t *pData, uint64_t WriteAddr, uint32_t BlockSize, uint32_t NumOfBlocks)
{
  if(HAL_SD_WriteBlocks(&hsd, pData, WriteAddr, BlockSize, NumOfBlocks) != SD_OK)  
  {
    return MSD_ERROR;
  }
  else
  {
    return MSD_OK;
  }
}

/**
  * @brief  Reads block(s) from a specified address in an SD card, in DMA mode. 
  * @param  pData: Pointer to the buffer that will contain the data to transmit
  * @param  ReadAddr: Address from where data is to be read  
  * @param  BlockSize: SD card data block size, that should be 512
  * @param  NumOfBlocks: Number of SD blocks to read 
  * @retval SD status
  */
uint8_t BSP_SD_ReadBlocks_DMA(uint32_t *pData, uint64_t ReadAddr, uint32_t BlockSize, uint32_t NumOfBlocks)
{
  uint8_t SD_state = MSD_OK;
  
  /* Read block(s) in DMA transfer mode */
  if(HAL_SD_ReadBlocks_DMA(&hsd, pData, ReadAddr, BlockSize, NumOfBlocks) != SD_OK)  
  {
    SD_state = MSD_ERROR;
  }
  else
  {
    SD_state = MSD_OK;
  }
  
  /* Wait until transfer is complete */
  if(SD_state == MSD_OK)
  {
    if(HAL_SD_CheckReadOperation(&hsd, (uint32_t)SD_DATATIMEOUT) != SD_OK)  
    {
      SD_state = MSD_ERROR;
    }
    else
    {
      SD_state = MSD_OK;
    }
  }
  
  return SD_state; 
}

/**
  * @brief  Writes block(s) to a specified address in an SD card, in DMA mode.  
  * @param  pData: Pointer to the buffer that will contain the data to transmit
  * @param  WriteAddr: Address from where data is to be written  
  * @param  BlockSize: SD card data block size, that should be 512
  * @param  NumOfBlocks: Number of SD blocks to write 
  * @retval SD status
  */
uint8_t BSP_SD_WriteBlocks_DMA(uint32_t *pData, uint64_t WriteAddr, uint32_t BlockSize, uint32_t NumOfBlocks)
{
  uint8_t SD_state = SD_OK;
  
  /* Write block(s) in DMA transfer mode */
  if(HAL_SD_WriteBlocks_DMA(&hsd, pData, WriteAddr, BlockSize, NumOfBlocks) != SD_OK)  
  {
    SD_state = MSD_ERROR;
  }
  else
  {
    SD_state = MSD_OK;
  }
  
  /* Wait until transfer is complete */
  if(SD_state == MSD_OK)
  {
    if(HAL_SD_CheckWriteOperation(&hsd, (uint32_t)SD_DATATIMEOUT) != SD_OK)  
    {
      SD_state = MSD_ERROR;
    }
    else
    {
      SD_state = MSD_OK;
    }
  }
  
  return SD_state; 
}

/**
  * @brief  Erases the specified memory area of the given SD card. 
  * @param  StartAddr: Start byte address
  * @param  EndAddr: End byte address
  * @retval SD status
  */
uint8_t BSP_SD_Erase(uint64_t StartAddr, uint64_t EndAddr)
{
  if(HAL_SD_Erase(&hsd, StartAddr, EndAddr) != SD_OK)  
  {
    return MSD_ERROR;
  }
  else
  {
    return MSD_OK;
  }
}

/**
  * @brief  Handles SD card interrupt request.
  * @param  None
  * @retval None
  */
void BSP_SD_IRQHandler(void)
{
  HAL_SD_IRQHandler(&hsd);
}

/**
  * @brief  Handles SD DMA Tx transfer interrupt request.
  * @param  None
  * @retval None
  */
void BSP_SD_DMA_Tx_IRQHandler(void)
{
  HAL_DMA_IRQHandler(hsd.hdmatx); 
}

/**
  * @brief  Handles SD DMA Rx transfer interrupt request.
  * @param  None
  * @retval None
  */
void BSP_SD_DMA_Rx_IRQHandler(void)
{
  HAL_DMA_IRQHandler(hsd.hdmarx);
}

/**
  * @brief  Gets the current SD card data status.
  * @param  None
  * @retval Data transfer state.
  *          This value can be one of the following values:
  *            @arg  SD_TRANSFER_OK: No data transfer is acting
  *            @arg  SD_TRANSFER_BUSY: Data transfer is acting
  *            @arg  SD_TRANSFER_ERROR: Data transfer error 
  */
HAL_SD_TransferStateTypedef BSP_SD_GetStatus(void)
{
  return(HAL_SD_GetStatus(&hsd));
}

/**
  * @brief  Get SD information about specific SD card.
  * @param  CardInfo: Pointer to HAL_SD_CardInfoTypedef structure
  * @retval None 
  */
void BSP_SD_GetCardInfo(HAL_SD_CardInfoTypedef* CardInfo)
{
  /* Get SD card Information */
  HAL_SD_Get_CardInfo(&hsd, CardInfo);
}

/**
 * @brief  Detects if SD card is correctly plugged in the memory slot or not.
 * @param  None
 * @retval Returns if SD is detected or not
 */
uint8_t BSP_SD_IsDetected(void)
{
  __IO uint8_t status = SD_PRESENT;

  /* TBI: add user code here depending on the hardware configuration used */
  
  return status;
}
/* USER CODE END 0 */

/************************ (C) COPYRIGHT STMicroelectronics *****END OF FILE****/
