brandonpollack23/super_game_bro/SW/GameMan_Template/Inc/DrawableObject.h

/* Drawable Object structure definition
** Brandon Pollack
*/
#ifndef __DRAWABLE_OBJECT_H
#define __DRAWABLE_OBJECT_H
#include "stdint.h"

typedef struct
{
	void (*render)(void* dobj); //render function pointer for a drawable object
	void (*update)(void* dobj); //update logical datas
	void* datas; //pointer to all logical game datas, including update function
	
	uint8_t prio; //draw priority (for queue insertion)
} DrawableObject;

typedef enum
{
	CPU_RENDER,
	DMA2D_RENDER
} RenderStyle;
#endif
