brandonpollack23/super_game_bro/doc/CARTRIDGES/IAP_EXAMPLE/Project/STM32F4xx_IAP/src/main.c

/**
  ******************************************************************************
  * @file    STM32F4xx_IAP/src/main.c 
  * @author  MCD Application Team
  * @version V1.0.0
  * @date    10-October-2011
  * @brief   Main program body
  ******************************************************************************
  * @attention
  *
  * THE PRESENT FIRMWARE WHICH IS FOR GUIDANCE ONLY AIMS AT PROVIDING CUSTOMERS
  * WITH CODING INFORMATION REGARDING THEIR PRODUCTS IN ORDER FOR THEM TO SAVE
  * TIME. AS A RESULT, STMICROELECTRONICS SHALL NOT BE HELD LIABLE FOR ANY
  * DIRECT, INDIRECT OR CONSEQUENTIAL DAMAGES WITH RESPECT TO ANY CLAIMS ARISING
  * FROM THE CONTENT OF SUCH FIRMWARE AND/OR THE USE MADE BY CUSTOMERS OF THE
  * CODING INFORMATION CONTAINED HEREIN IN CONNECTION WITH THEIR PRODUCTS.
  *
  * <h2><center>&copy; COPYRIGHT 2011 STMicroelectronics</center></h2>
  ******************************************************************************
  */ 

/** @addtogroup STM32F4xx_IAP
  * @{
  */

/* Includes ------------------------------------------------------------------*/
#include "menu.h"
#include "stm324xg_eval.h"

/* Private typedef -----------------------------------------------------------*/
/* Private define ------------------------------------------------------------*/
/* Private macro -------------------------------------------------------------*/
/* Private variables ---------------------------------------------------------*/
extern pFunction Jump_To_Application;
extern uint32_t JumpAddress;

/* Private function prototypes -----------------------------------------------*/
static void IAP_Init(void);

/* Private functions ---------------------------------------------------------*/

/**
  * @brief  Main program.
  * @param  None
  * @retval None
  */
int main(void)
{
  /* Unlock the Flash Program Erase controller */
  FLASH_If_Init();

  /* Initialize Key Button mounted on STM324xG-EVAL board */
  STM_EVAL_PBInit(BUTTON_KEY, BUTTON_MODE_GPIO);

  /* Test if Key push-button on STM324xG-EVAL Board is pressed */
  if (STM_EVAL_PBGetState(BUTTON_KEY) == 0x00)
  { 
    /* Execute the IAP driver in order to reprogram the Flash */
    IAP_Init();
    /* Display main menu */
    Main_Menu ();
  }
  /* Keep the user application running */
  else
  {
    /* Test if user code is programmed starting from address "APPLICATION_ADDRESS" */
    
      /* Jump to user application */
      JumpAddress = *(__IO uint32_t*) (APPLICATION_ADDRESS + 4 + 1);
      Jump_To_Application = (pFunction) JumpAddress;
      /* Initialize user application's Stack Pointer */
      __set_MSP(*(__IO uint32_t*) APPLICATION_ADDRESS);
      Jump_To_Application();
    
  }

  while (1)
  {}
}

/**
  * @brief  Initialize the IAP: Configure USART.
  * @param  None
  * @retval None
  */
void IAP_Init(void)
{
 USART_InitTypeDef USART_InitStructure;

  /* USART resources configuration (Clock, GPIO pins and USART registers) ----*/
  /* USART configured as follow:
        - BaudRate = 115200 baud  
        - Word Length = 8 Bits
        - One Stop Bit
        - No parity
        - Hardware flow control disabled (RTS and CTS signals)
        - Receive and transmit enabled
  */
  USART_InitStructure.USART_BaudRate = 115200;
  USART_InitStructure.USART_WordLength = USART_WordLength_8b;
  USART_InitStructure.USART_StopBits = USART_StopBits_1;
  USART_InitStructure.USART_Parity = USART_Parity_No;
  USART_InitStructure.USART_HardwareFlowControl = USART_HardwareFlowControl_None;
  USART_InitStructure.USART_Mode = USART_Mode_Rx | USART_Mode_Tx;

  STM_EVAL_COMInit(COM1, &USART_InitStructure);
}

#ifdef USE_FULL_ASSERT
/**
  * @brief  Reports the name of the source file and the source line number
  *         where the assert_param error has occurred.
  * @param  file: pointer to the source file name
  * @param  line: assert_param error line source number
  * @retval None
  */
void assert_failed(uint8_t* file, uint32_t line)
{
  /* User can add his own implementation to report the file name and line number,
     ex: printf("Wrong parameters value: file %s on line %d\r\n", file, line) */

  /* Infinite loop */
  while (1)
  {
  }
}
#endif

/**
  * @}
  */

/******************* (C) COPYRIGHT 2011 STMicroelectronics *****END OF FILE****/
