brandonpollack23/super_game_bro/(commit log)

2015-01-30 initial commit, only implemented drawable object and the drawable queue so far
    [Audio.PcbDoc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]
2015-02-01 added beginnings of gamelogic and menus
    [2015-01-31_17-57-461.schdoc, 2015-01-31_17-58-54.PcbDoc]
2015-03-11 added all files mentioned in last commit
    [2015-01-31_17-57-461.schdoc, 2015-01-31_17-58-54.PcbDoc, Audio.SchDoc, Audio_Breakout.PrjPcb, Buttons.SchDoc, CPU_Power_XTAL_Prog.SchDoc, Control_Sig.SchDoc, Control_Sig.~(9).SchDoc]
2015-03-12 added link DObj and put him in test game
    [Control_Sig.SchDoc, Control_Sig_old.SchDoc, Power.PcbDoc, Power.PrjPcb, Power.SchDoc]
